eduardofilo/eduzebox/images/2-piezas-de-21-pines-de-ngulo-recto-conector-de-enchufe-Scar.jpg

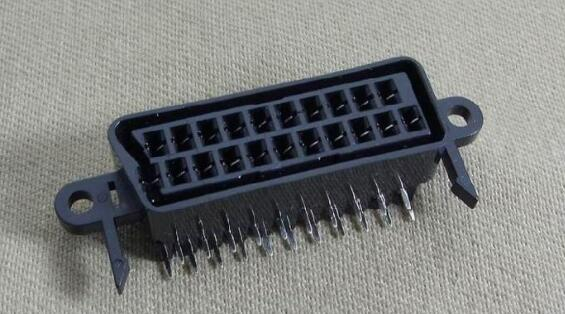
images/2-piezas-de-21-pines-de-ngulo-recto-conector-de-enchufe-Scar.jpg
