eduardofilo/eduzebox/README.md

# EdUzebox

Uzebox clone with SCART connector (RGB output) and most SMD components.

https://apuntes.eduardofilo.es/2020-02-08-eduzebox.html
