eduardofilo/eduzebox/images/microsd_pinout.jpeg

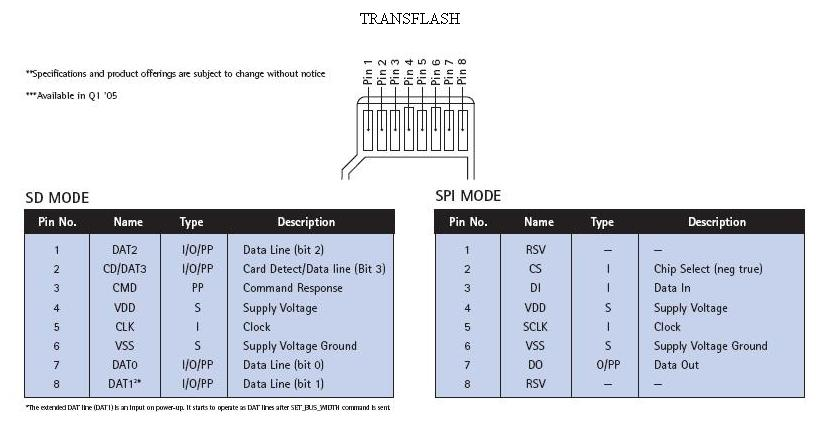
images/microsd_pinout.jpeg
