eduardofilo/eduzebox/bom.ods

Reference | Quantity | Value | Footprint | URL | Datasheet | DC
C1 | 1 | 330n | Capacitor_SMD:C_0805_2012Metric_Pad1.15x1.40mm_HandSolder | https://lcsc.com/product-detail/Multilayer-Ceramic-Capacitors-MLCC-SMD-SMT_FH-Guangdong-Fenghua-Advanced-Tech-0805F334M500NT_C1775.html | ~
C2 C7 C8 | 3 | 100n | Capacitor_SMD:C_0805_2012Metric_Pad1.15x1.40mm_HandSolder | https://lcsc.com/product-detail/Others_YAGEO-AC0805KRX7R9BB104_C277502.html | ~
C3 | 1 | 10u | Capacitor_Tantalum_SMD:CP_EIA-3216-18_Kemet-A_Pad1.58x1.35mm_HandSolder | https://lcsc.com/product-detail/Tantalum-Capacitors_AVX_TAJA106K010RNJ_10uF-106-10-10V_C7177.html | ~
C4 | 1 | 1u | Capacitor_Tantalum_SMD:CP_EIA-3216-18_Kemet-A_Pad1.58x1.35mm_HandSolder | https://lcsc.com/product-detail/Tantalum-Capacitors_AVX_TAJA105K035RNJ_1uF-105-10-35V_C7176.html | ~
C5 C6 | 2 | 22p | Capacitor_SMD:C_0805_2012Metric_Pad1.15x1.40mm_HandSolder | https://lcsc.com/product-detail/New-Arrivals_Samsung-Electro-Mechanics-CL21B223JBANNNC_C380538.html | ~
D1 | 1 | 1N4001 | Diode_SMD:D_SOD-123F | https://lcsc.com/product-detail/Diodes-General-Purpose_Shandong-Jingdao-Microelectronics-1N4001W_C162732.html | http://www.vishay.com/docs/88503/1n4001.pdf
D2 | 1 | RED LED | LED_THT:LED_D5.0mm | https://lcsc.com/product-detail/Others_TOGIALED-TJ-L5FYTGHRMBCSFLC4R-A5_C331027.html | ~
D3 | 1 | BLUE LED | LED_THT:LED_D5.0mm | https://es.aliexpress.com/item/1206541951.html | ~
J1 | 1 | Barrel_Jack | Connector_BarrelJack:BarrelJack_Wuerth_6941xx301002 | https://lcsc.com/product-detail/New-Arrivals_XKB-Enterprise-DC-005-5A-2-0_C381116.html | ~ | 9-12V
J2 | 1 | Micro_SD_Card | Connector_Card:microSD_HC_Wuerth_693072010801 | https://lcsc.com/product-detail/Card-Sockets-Connectors_Korean-Hroparts-Elec-TF-04A_C145799.html | http://katalog.we-online.de/em/datasheet/693072010801.pdf
J3 | 1 | AVR-ISP-6 | Connector_PinHeader_2.54mm:PinHeader_2x03_P2.54mm_Vertical |  | ~
J4 | 1 | SCART-F | eduzebox:SCART | https://www.aliexpress.com/item/32997772379.html | ~
R1 | 1 | 10K | Resistor_SMD:R_0805_2012Metric_Pad1.15x1.40mm_HandSolder | https://lcsc.com/product-detail/Chip-Resistor-Surface-Mount_10KR-1002-1_C84376.html | ~
R10 R12 R7 | 3 | 1K5 | Resistor_SMD:R_0805_2012Metric_Pad1.15x1.40mm_HandSolder | https://lcsc.com/product-detail/Chip-Resistor-Surface-Mount_UNI-ROYAL-Uniroyal-Elec-0805W8F1501T5E_C4310.html | ~
R11 R13 R8 | 3 | 750 | Resistor_SMD:R_0805_2012Metric_Pad1.15x1.40mm_HandSolder | https://lcsc.com/product-detail/Chip-Resistor-Surface-Mount_UNI-ROYAL-Uniroyal-Elec-0805W8F7500T5E_C17818.html | ~
R16 R15 R14 | 3 | 75 | Resistor_SMD:R_0805_2012Metric_Pad1.15x1.40mm_HandSolder | https://lcsc.com/product-detail/Chip-Resistor-Surface-Mount_UNI-ROYAL-Uniroyal-Elec-0805W8F750JT5E_C17820.html | ~
R18 R17 R19 | 3 | 1K8 | Resistor_SMD:R_0805_2012Metric_Pad1.15x1.40mm_HandSolder | https://lcsc.com/product-detail/Chip-Resistor-Surface-Mount_UNI-ROYAL-Uniroyal-Elec-0805W8F1801T5E_C17398.html | ~
R2 R4 | 2 | 470 | Resistor_SMD:R_0805_2012Metric_Pad1.15x1.40mm_HandSolder | https://lcsc.com/product-detail/Chip-Resistor-Surface-Mount_LIZ-Elec-CR0805F84700G_C101745.html | ~
R20 R21 R22 | 3 | 3K3 | Resistor_SMD:R_0805_2012Metric_Pad1.15x1.40mm_HandSolder | https://lcsc.com/product-detail/Chip-Resistor-Surface-Mount_UNI-ROYAL-Uniroyal-Elec-0805W8F3301T5E_C26010.html | ~
R23 | 1 | 160 | Resistor_SMD:R_0805_2012Metric_Pad1.15x1.40mm_HandSolder | https://lcsc.com/product-detail/Chip-Resistor-Surface-Mount_UNI-ROYAL-Uniroyal-Elec-0805W8F1600T5E_C25269.html | ~
R3 | 1 | 220 | Resistor_SMD:R_0805_2012Metric_Pad1.15x1.40mm_HandSolder | https://lcsc.com/product-detail/Chip-Resistor-Surface-Mount_UNI-ROYAL-Uniroyal-Elec-0805W8F2200T5E_C17557.html | ~
R5 | 1 | 1K | Resistor_SMD:R_0805_2012Metric_Pad1.15x1.40mm_HandSolder | https://lcsc.com/product-detail/Chip-Resistor-Surface-Mount_UNI-ROYAL-Uniroyal-Elec-0805W8F1001T5E_C17513.html | ~
R9 R6 | 2 | 3K | Resistor_SMD:R_0805_2012Metric_Pad1.15x1.40mm_HandSolder | https://lcsc.com/product-detail/Chip-Resistor-Surface-Mount_UNI-ROYAL-Uniroyal-Elec-0805W8F3001T5E_C17661.html | ~
SW1 | 1 | Reset | Button_Switch_SMD:SW_Push_1P1T_NO_6x6mm_H9.5mm | https://lcsc.com/product-detail/Tactile-Switches_E-Switch_TL3301DF260QG_E-Switch-TL3301DF260QG_C273525.html | ~
SW2 | 1 | SK12D07VG4 | Button_Switch_THT:SW_CuK_OS102011MA1QN1_SPDT_Angled | https://lcsc.com/product-detail/Toggle-Switches_SHOU-HAN-SK12D07VG4_C393937.html
U1 | 1 | L7805T | Package_TO_SOT_THT:TO-220-3_Vertical | https://es.aliexpress.com/item/32892570189.html | http://www.st.com/content/ccc/resource/technical/document/datasheet/41/4f/b3/b0/12/d4/47/88/CD00000444.pdf/files/CD00000444.pdf/jcr:content/translations/en.CD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
U2 | 1 | MCP1700-3302E_SOT23 | Package_TO_SOT_SMD:SOT-23 | https://lcsc.com/product-detail/Low-Dropout-Regulators-LDO_MICROCHIP_MCP1700T-3302E-TT_MCP1700T-3302E-TT_C39051.html | http://ww1.microchip.com/downloads/en/DeviceDoc/20001826D.pdf
U3 | 1 | ATmega644P-20AU | Package_QFP:TQFP-44_10x10mm_P0.8mm | https://lcsc.com/product-detail/Others_Microchip-Tech_ATMEGA644P-20AU_Microchip-Tech-ATMEGA644P-20AU_C219112.html | http://ww1.microchip.com/downloads/en/DeviceDoc/Atmel-42744-ATmega644P_Datasheet.pdf
X1 X2 | 2 | SNES_Connector | eduzebox:SNES | https://www.aliexpress.com/item/32828768824.html
Y1 | 1 | 28,6363 | Crystal:Crystal_HC49-4H_Vertical | https://lcsc.com/product-detail/DIP-Crystal-Resonators_Suzhou-Liming-Elec-49S-28-63636-20-20-A_C240948.html | ~
 | 4 | M2.5x4 Screws |  | https://es.aliexpress.com/item/32787593421.html
