eduardofilo/eduzebox/case/case_inferior.stl

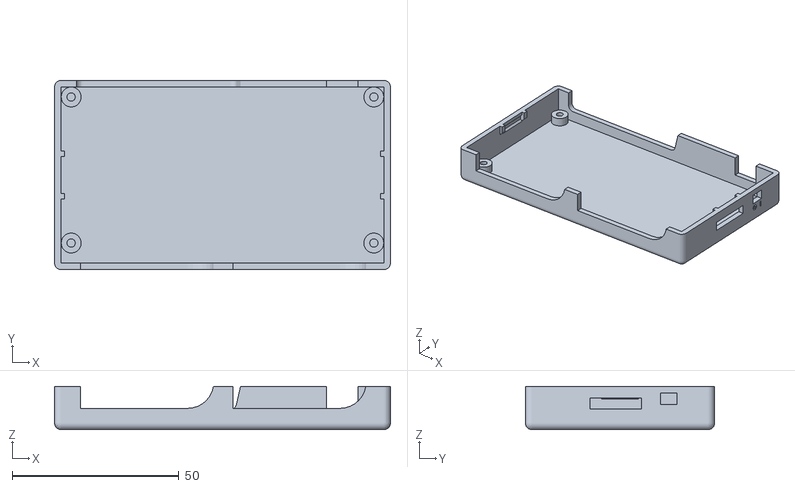
[picture p3: CAD file, 2020-08-08]
case/case_inferior.stl
100.8 x 56.8 x 13.0
