eduardofilo/eduzebox/case/case_superior.stl

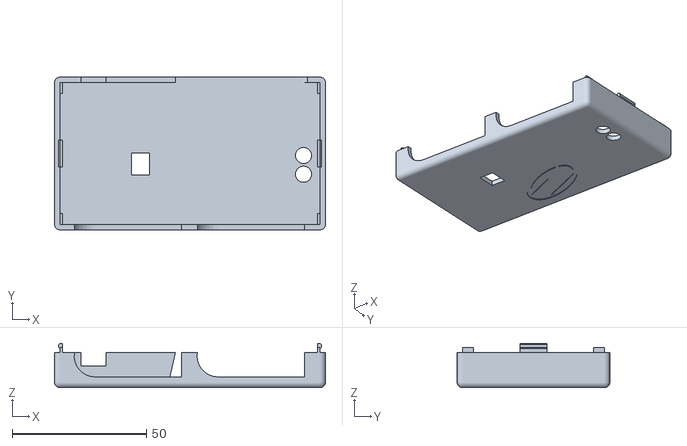
[picture p4: CAD file, 2020-08-08]
case/case_superior.stl
100.8 x 56.8 x 16.5
