eduardofilo/eduzebox/case/case_RESET.stl

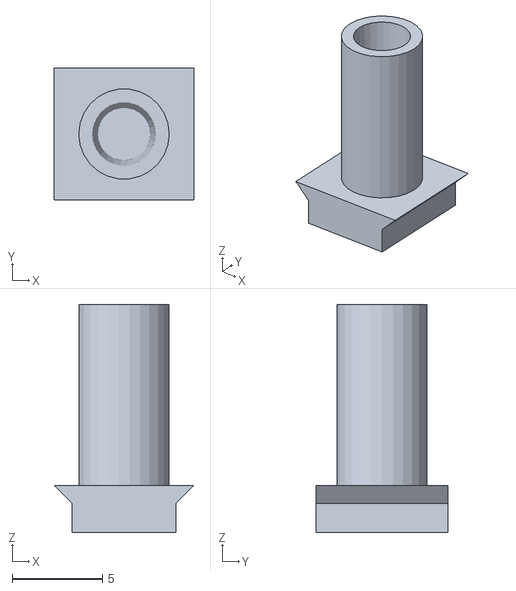
[picture p5: CAD file, 2020-08-08]
case/case_RESET.stl
7.73 x 7.29 x 12.6
