eduardofilo/eduzebox/case/case.FCStd

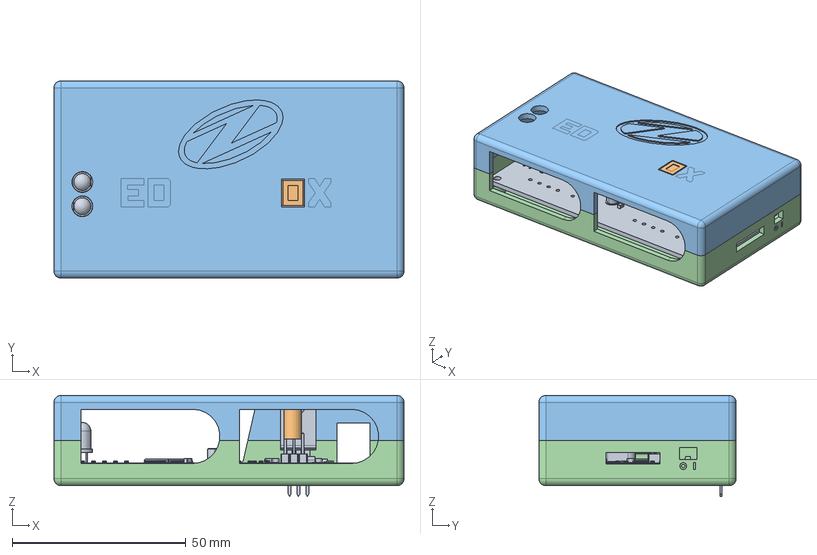
[picture p6: CAD file, 2020-08-08]
case/case.FCStd
100.8 x 56.8 x 29.1 mm
PCB
RESET
Superior
Inferior
