eduardofilo/eduzebox/eduzebox.kicad_pcb

## KiCad design eduzebox.kicad_pcb (2020-02-04)

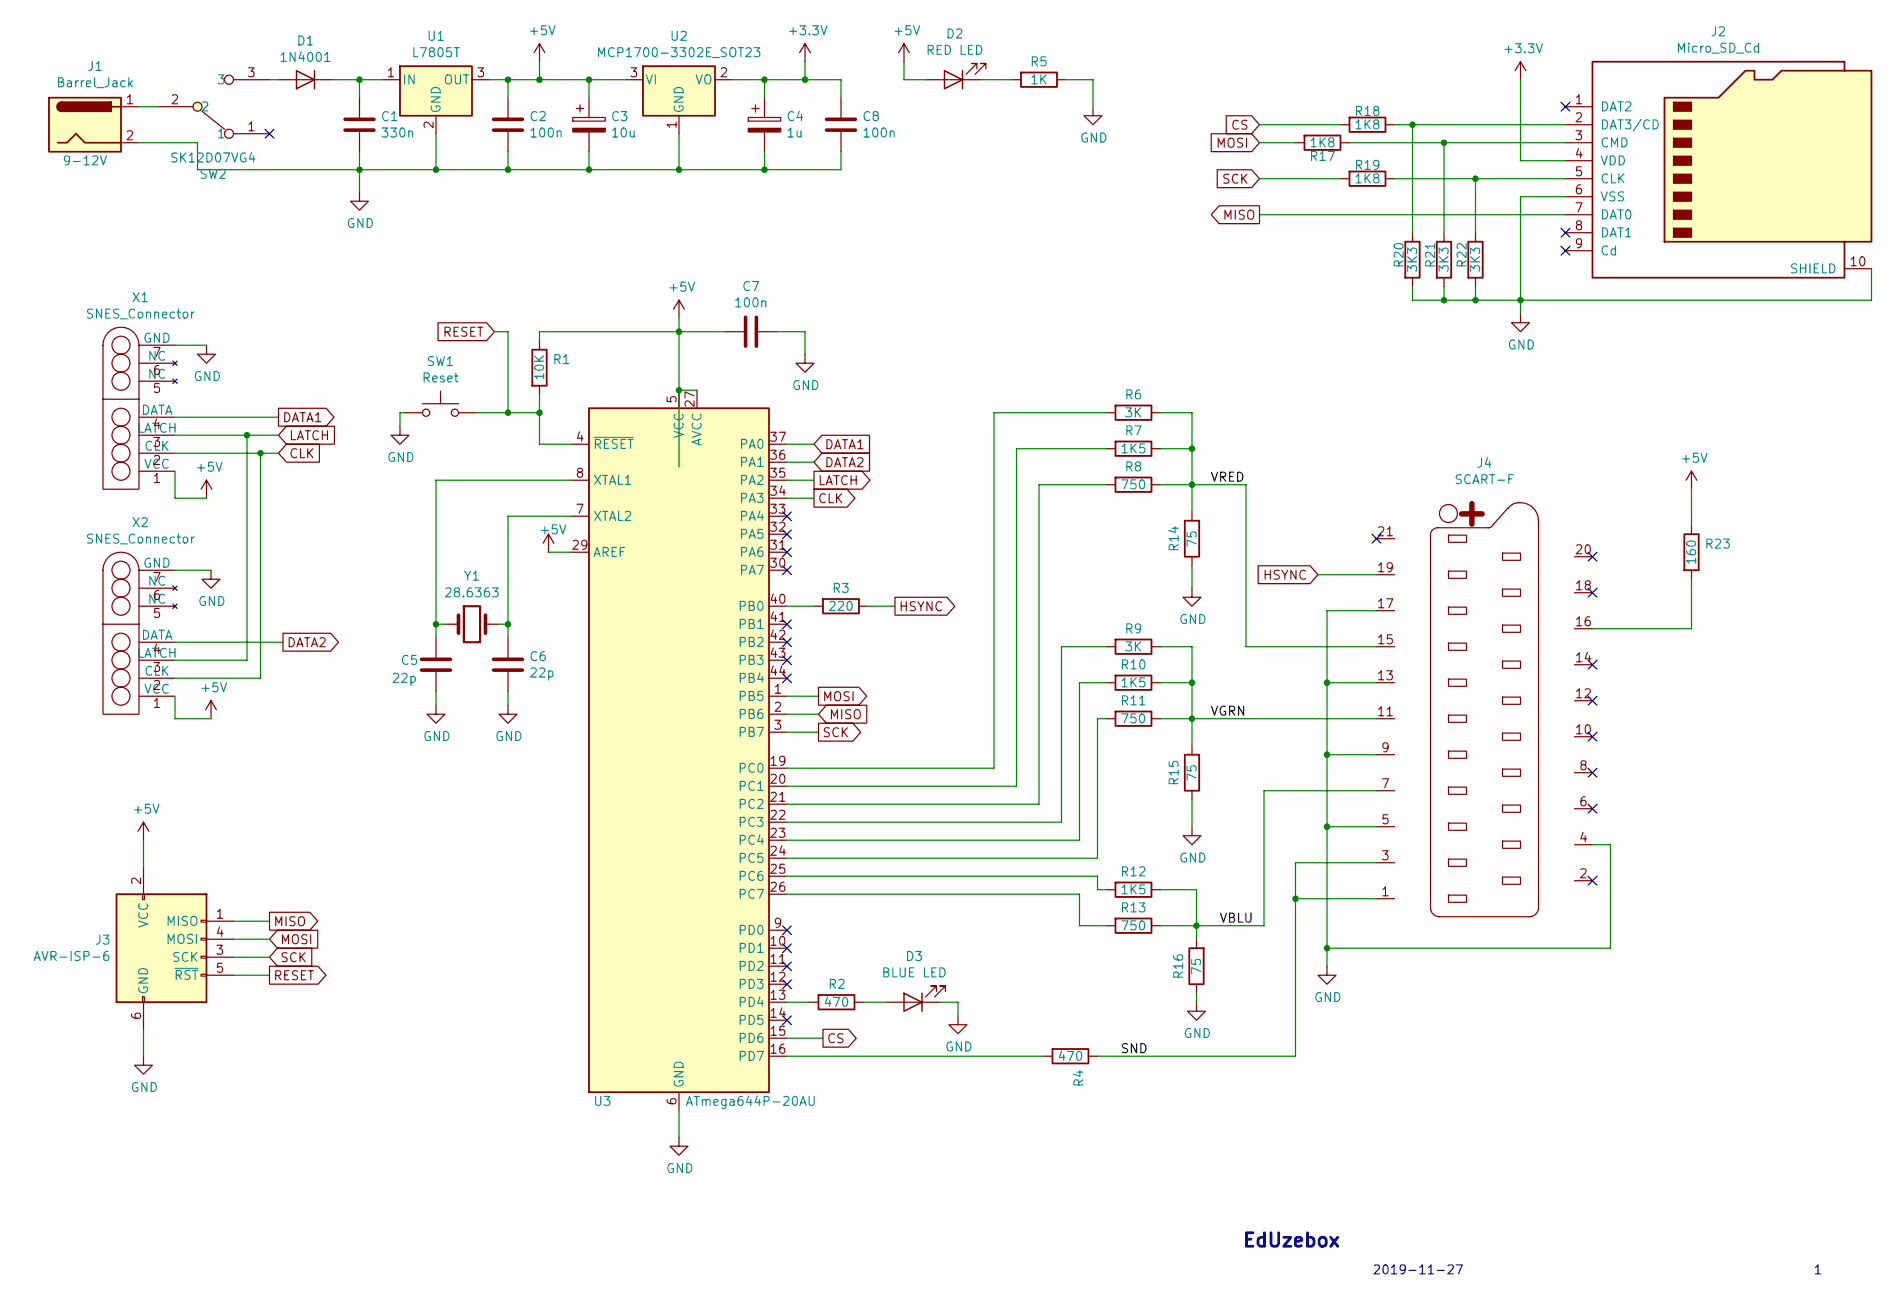
[picture p7: schematic eduzebox.sch]

Parts:
C1: 330n; C_0805_2012Metric_Pad1.15x1.40mm_HandSolder
C2, C7, C8: 100n; C_0805_2012Metric_Pad1.15x1.40mm_HandSolder
C3: 10u; CP_EIA-3216-18_Kemet-A_Pad1.58x1.35mm_HandSolder
C4: 1u; CP_EIA-3216-18_Kemet-A_Pad1.58x1.35mm_HandSolder
C5, C6: 22p; C_0805_2012Metric_Pad1.15x1.40mm_HandSolder
D1: 1N4001; D_SOD-123F
D2: RED LED; LED_D5.0mm
D3: BLUE LED; LED_D5.0mm
J1: Barrel_Jack; BarrelJack_Wuerth_6941xx301002
J2: Micro_SD_Cd
J3: AVR-ISP-6; PinHeader_2x03_P2.54mm_Vertical
J4: SCART-F; SCART
R1: 10K; R_0805_2012Metric_Pad1.15x1.40mm_HandSolder
R2, R4: 470; R_0805_2012Metric_Pad1.15x1.40mm_HandSolder
R3: 220; R_0805_2012Metric_Pad1.15x1.40mm_HandSolder
R5: 1K; R_0805_2012Metric_Pad1.15x1.40mm_HandSolder
R6, R9: 3K; R_0805_2012Metric_Pad1.15x1.40mm_HandSolder
R7, R10, R12: 1K5; R_0805_2012Metric_Pad1.15x1.40mm_HandSolder
R8, R11, R13: 750; R_0805_2012Metric_Pad1.15x1.40mm_HandSolder
R14, R15, R16: 75; R_0805_2012Metric_Pad1.15x1.40mm_HandSolder
R17, R18, R19: 1K8; R_0805_2012Metric_Pad1.15x1.40mm_HandSolder
R20, R21, R22: 3K3; R_0805_2012Metric_Pad1.15x1.40mm_HandSolder
R23: 160; R_0805_2012Metric_Pad1.15x1.40mm_HandSolder
SW1: Reset; SW_Push_1P1T_NO_6x6mm_H9.5mm
SW2: SK12D07VG4; SW_CuK_OS102011MA1QN1_SPDT_Angled
U1: L7805T; TO-220-3_Vertical
U2: MCP1700-3302E_SOT23; SOT-23
U3: ATmega644P-20AU; TQFP-44_10x10mm_P0.8mm
X1, X2: SNES_Connector; SNES
Y1: 28.6363; Crystal_HC49-4H_Vertical

Connections:
+3V3: C4.1, C8.1, J2.4 (VDD), U2.2 (VO)
+5V: C2.1, C3.1, C7.2, D2.2 (A), J3.2 (VCC), R1.1, R23.1, U1.3 (OUT), U2.3 (VI), U3.5 (VCC), U3.17 (VCC), U3.27 (AVCC), U3.29 (AREF), U3.38 (VCC), X1.1 (VCC), X2.1 (VCC)
/SND: J4.1, J4.3, R4.1
/VBLU: J4.7, R12.1, R13.1, R16.2
/VGRN: J4.11, R9.1, R10.1, R11.1, R15.2
/VRED: J4.15, R6.1, R7.1, R8.1, R14.2
CLK: U3.34 (PA3), X1.2 (CLK), X2.2 (CLK)
CS: R18.2, U3.15 (PD6)
DATA1: U3.37 (PA0), X1.4 (DATA)
DATA2: U3.36 (PA1), X2.4 (DATA)
GND: C1.2, C2.2, C3.2, C4.2, C5.2, C6.2, C7.1, C8.2, D3.1 (K), J1.2, J2.6 (VSS), J2.10 (SHIELD), J3.6 (GND), J4.4, J4.5, J4.9, J4.13, J4.17, R5.1, R14.1, R15.1, R16.1, R20.2, R21.2, R22.2, SW1.1, U1.2 (GND), U2.1 (GND), U3.6 (GND), U3.18 (GND), U3.28 (GND), U3.39 (GND), X1.7 (GND), X2.7 (GND)
HSYNC: J4.19, R3.1
LATCH: U3.35 (PA2), X1.3 (LATCH), X2.3 (LATCH)
MISO: J2.7 (DAT0), J3.1 (MISO), U3.2 (PB6)
MOSI: J3.4 (MOSI), R17.2, U3.1 (PB5)
unnamed: C1.1, D1.1 (K), U1.1 (IN)
unnamed: C5.1, U3.8 (XTAL1), Y1.1
unnamed: C6.1, U3.7 (XTAL2), Y1.2
unnamed: D1.2 (A), SW2.3
unnamed: D2.1 (K), R5.2
unnamed: D3.2 (A), R2.1
unnamed: J1.1, SW2.2
unnamed: J2.2 (DAT3/CD), R18.1, R20.1
unnamed: J2.3 (CMD), R17.1, R21.1
unnamed: J2.5 (CLK), R19.1, R22.1
unnamed: J4.16, R23.2
unnamed: R2.2, U3.13 (PD4)
unnamed: R3.2, U3.40 (PB0)
unnamed: R4.2, U3.16 (PD7)
unnamed: R6.2, U3.19 (PC0)
unnamed: R7.2, U3.20 (PC1)
unnamed: R8.2, U3.21 (PC2)
unnamed: R9.2, U3.22 (PC3)
unnamed: R10.2, U3.23 (PC4)
unnamed: R11.2, U3.24 (PC5)
unnamed: R12.2, U3.25 (PC6)
unnamed: R13.2, U3.26 (PC7)
RESET: J3.5 (~RST), R1.2, SW1.2, U3.4 (~RESET)
SCK: J3.3 (SCK), R19.2, U3.3 (PB7)

Notes on the sheet:
EdUzebox
2019-11-27

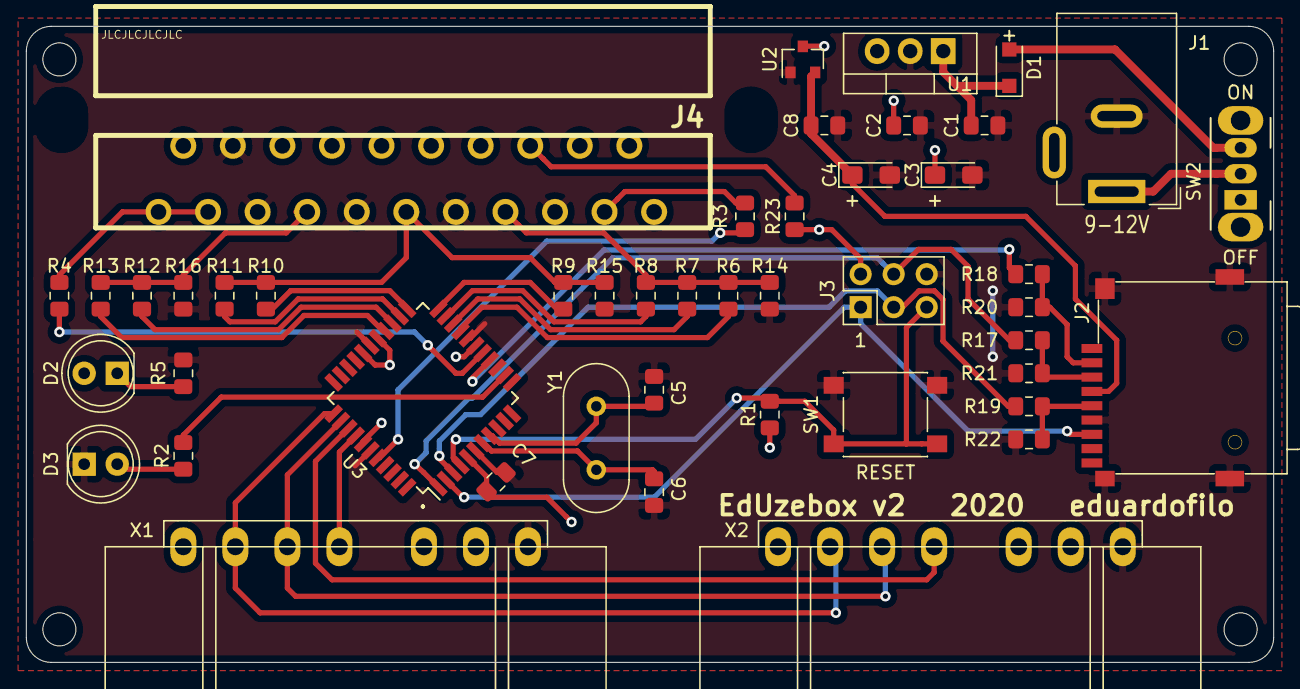
[picture p8: board eduzebox.kicad_pcb from above]

Board: 2 copper layers, 95.9 x 48.9 mm, 46 parts (0 on the bottom side), 39 nets.
