eduardofilo/eduzebox/(commit log)

2020-02-04 First commit.
    [bom.ods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]
2020-02-15 Se incorpora el 7805 a la hoja BOM.
    [bom.ods]
2020-08-08 Añadidos tornillos a BOM.
    [bom.ods]
2020-08-08 Ficheros de la carcasa (FreeCAD y STLs).
    [case.FCStd, case_RESET.stl, case_inferior.stl, case_superior.stl]
2020-08-09 Enlace a post de proyecto en README.
